hotchk155/six4mix/docs/six4mix packing slip.docx

six4mix 6:1 audio

six4mix is a basic, six input, summing mixer taking 12HP in 1U format. It has a mono signal path and AC coupled inputs. It is ideal for creating sub-mixes within the rack for further filtering (e.g. for percussion kits) but can also be used as a simple master mixer, with the added benefit of a line level output (e.g. for connecting to external amplification or recording equipment)

Each input accepts a modular level audio signal and has a corresponding level potentiometer which allows signal level to be adjusted from muted to 2x voltage gain. Turn the level knob fully to the left to mute a signal.

The white markings on the fascia indicate the signal inputs and level knobs for even numbered channels, with the remaining sockets and knobs for the odd numbered channels.

The modular level summed mix is output from the MIX OUT socket and an attenuated (line level) buffered copy of the same signal is output from the LINE LVL socket. The black knob to the far right is the master output level which offers an additional 1.6x voltage gain. Reduce this level if the output is clipping.

six4mix is fitted with a front panel which fits into ‘Intellijel’ standard height 1U racks. It is also supplied with an alternative front panel to fit ‘Pulp Logic’ standard height 1U racks. Temporarily remove the knobs from the pots and nuts from the sockets to switch the panels.

When attaching the supplied power cable, ensure that the red stripe on the cable matches up with the ‘Red Stripe’ marking beside the power input pins. Take care not to damage the pins or pull the small power adaptor board when plugging or unplugging the power cable from the module.

Please check out six4pix.com/six4mix for more information
