hotchk155/six4mix/fascia/frontsilk.png

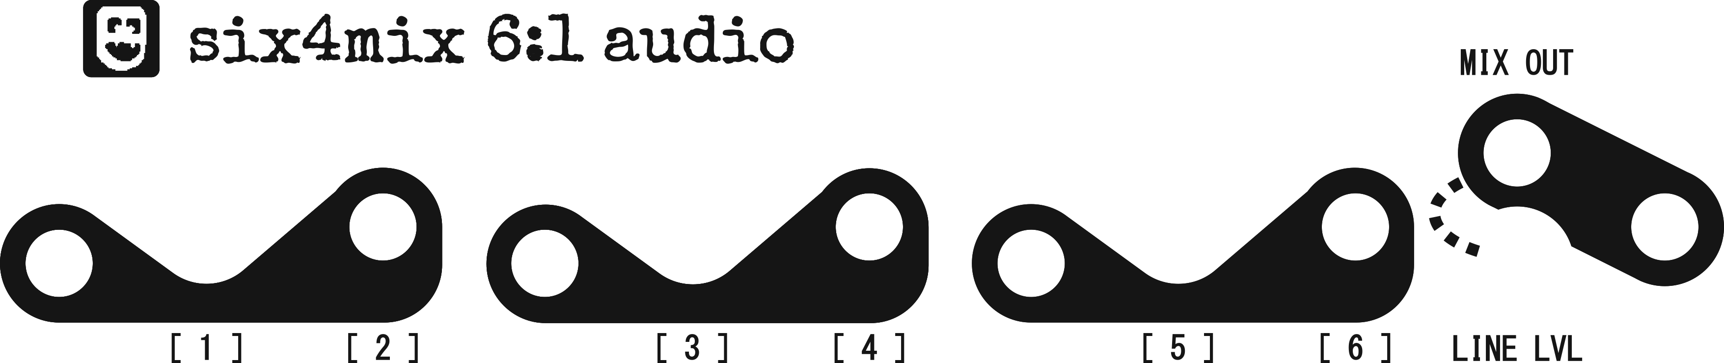
fascia/frontsilk.png
