hotchk155/six4mix/docs/six4mix_BOM.xlsx

 |  |  | 30
C3, C4, C7, C8 ,C11, C12, C15, C16 | 100nF Capacitor 0805 | 8 | 240 | 0.05 | 0.4
D1, D2 | MBR0520LT Schottky Diode | 2 | 60 | 0.15 | 0.3
FB1, FB2 | Ferrite Bead 0603 | 2 | 60 | 0.05 | 0.1
IC1, IC2, IC3, IC4 | NE5532ADR Op-Amp | 4 | 120 | 0.4 | 1.6
R1 | 100k Resistor 0805 | 1 | 30 | 0.02 | 0.02
R2, R4, R5, R7, R8, R9, R11, R13 | 10k Resistor 0805 | 14 | 420 | 0.02 | 0.28
R14, R15, R17, R19, R20, R21 |  |  |  |  | 0
R3 | 47k Resistor 0805 | 1 | 30 | 0.02 | 0.02
R6, R10, R12, R16, R18, R22 | 4k7 Resistor 0805 | 6 | 180 | 0.02 | 0.12
Panel jack x 8 | PJ301M Jack Thonkiconn | 8 | 240 | 0.22 | 1.76
Panel pots x 7 | ALPS 9MM Pot A100K | 7 | 210 | 0.8 | 5.6
C1, C2, C5, C6, C9, C10, C13, C14, C17, C18 | Electrolytic cap 10uF | 10 | 300 | 0.05 | 0.5
Front panel PCB Intellijel |  | 1 | 30 | 0.8 | 0.8
Front panel PCB Pulp |  | 1 | 30 | 0.8 | 0.8
Main PCB |  | 1 | 30 | 0.5 | 0.5
Power connection PCB |  | 1 | 30 | 0.2 | 0.2
Panel jack nuts x 8 |  | 8 | 240 | 0.05 | 0.4
SMT DIL connector 10 pin |  | 1 | 30 | 0.05 | 0.05
3 pin SIL header |  | 1 | 30 | 0.01 | 0.01
Power ribbon cable | Thonk cable | 1 | 30 | 1.59 | 1.59
Black pot topper knob x 1 | Thonk topper | 1 | 30 | 0.25 | 0.25
Gray pot topper knob x 6 | Thonk topper | 6 | 180 | 0.25 | 1.5
Knurlies |  | 4 | 120 | 0.27 | 1.08
Box |  | 1 | 30 | 0.3 | 0.3
Labour |  | 0.5 | 15 | 15 | 7.5
