hotchk155/six4mix/six4mix_power/six4mix_power.brd

## EAGLE design six4mix_power/six4mix_power.brd (2022-11-22)

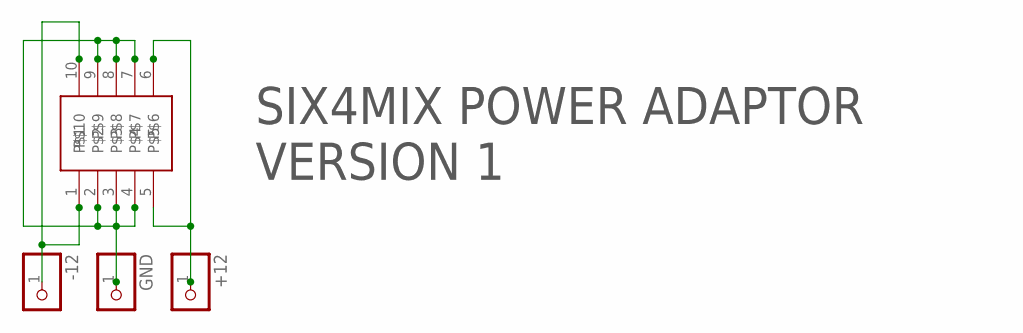
[picture p2: schematic six4mix_power.sch]

Parts:
+12: PINHD-1X1; 1X01
-12: PINHD-1X1; 1X01
GND: PINHD-1X1; 1X01
U$1: 2X5SMT

Connections:
GND: GND.1, U$1.2, U$1.3, U$1.4, U$1.7, U$1.8, U$1.9
unnamed: -12.1, U$1.1, U$1.10
unnamed: +12.1, U$1.5, U$1.6

Notes on the sheet:
SIX4MIX POWER ADAPTOR VERSION 1

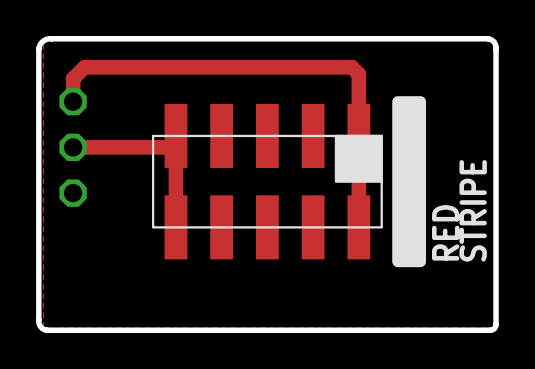
[picture p3: board six4mix_power.brd from above]

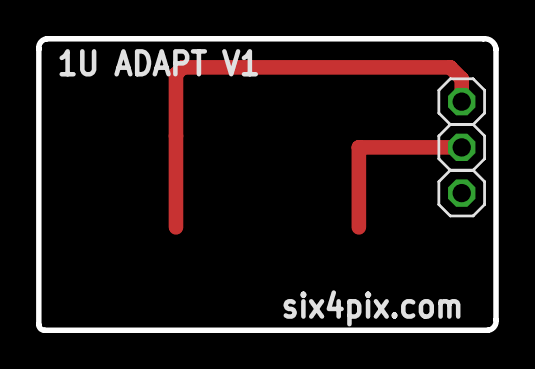
[picture p4: board six4mix_power.brd from below]

Board: 2 copper layers, 25.4 x 16.2 mm, 4 parts (3 on the bottom side), 3 nets.
