hotchk155/six4mix/hardware/six4mix.brd

## EAGLE design hardware/six4mix.brd (2022-08-08)

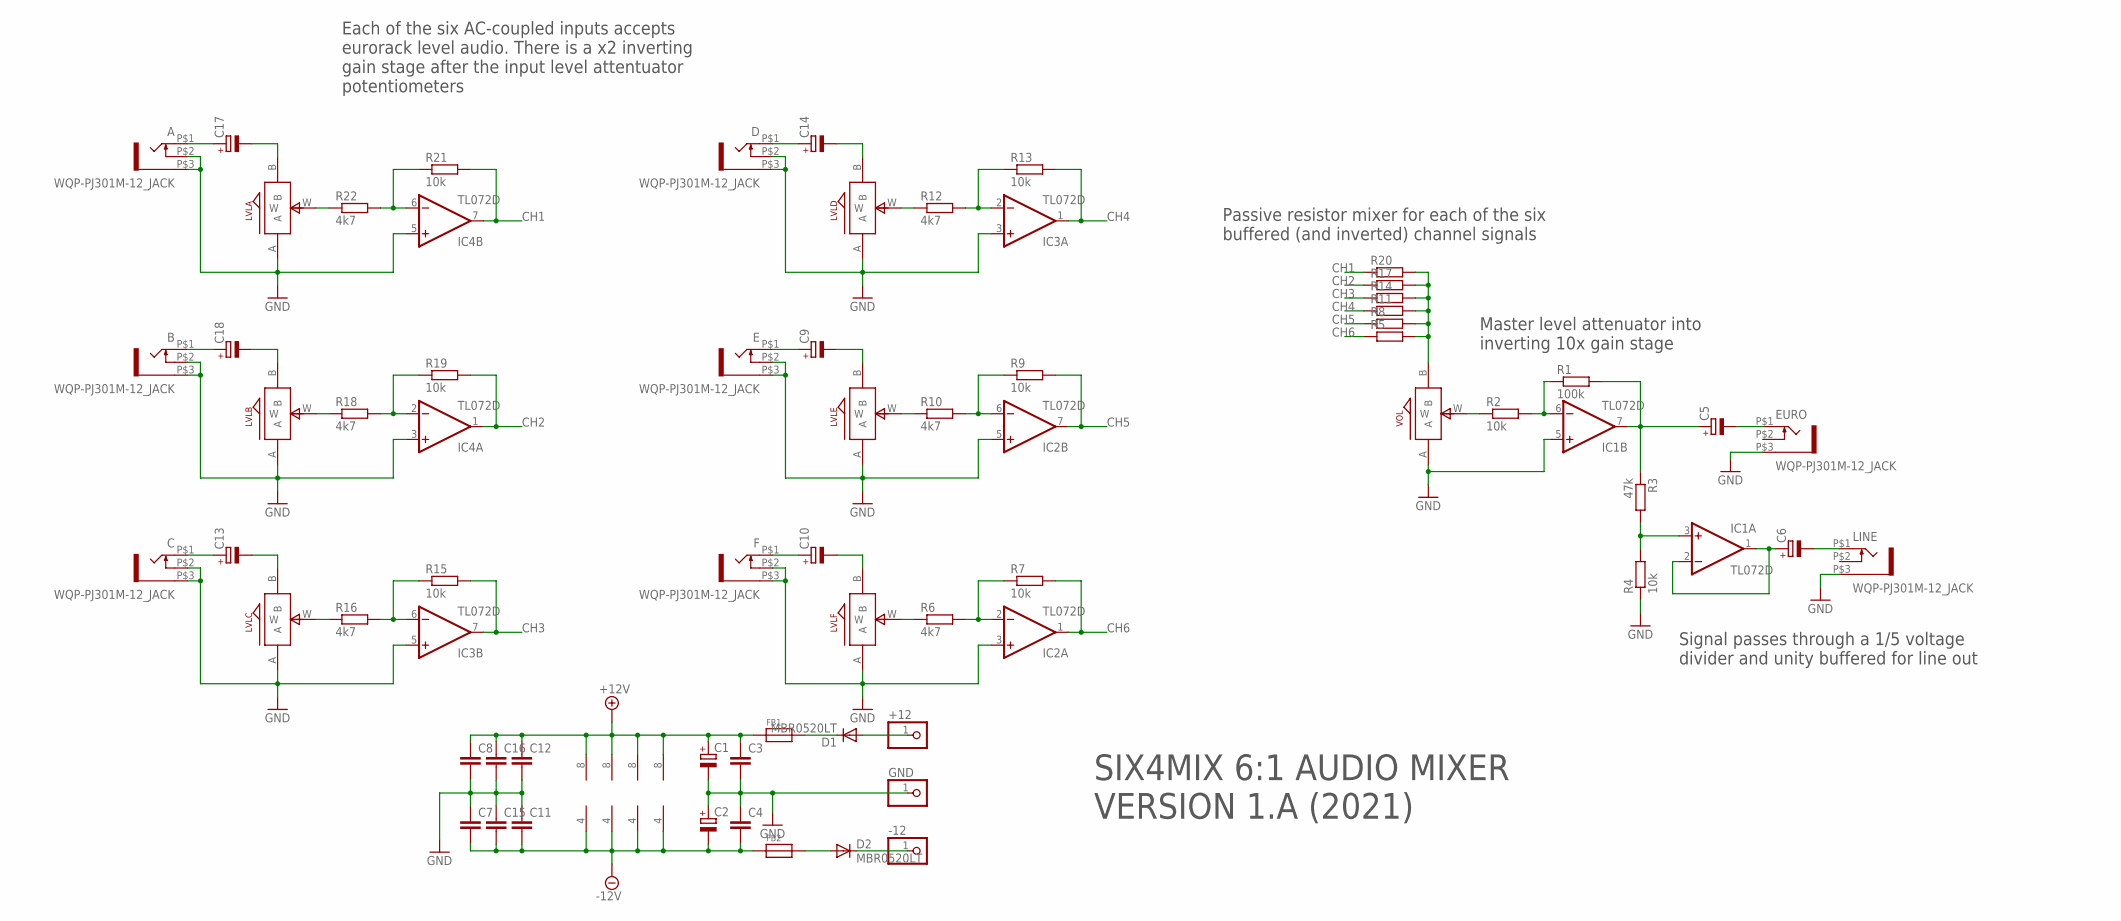
[picture p5: schematic six4mix.sch]

Parts:
+12: PINHD-1X1; 1X01
-12: PINHD-1X1; 1X01
A: WQP-PJ301M-12_JACK
B: WQP-PJ301M-12_JACK
C: WQP-PJ301M-12_JACK
C1, C2, C5, C6, C9, C10, C13, C14, C17, C18: CPOL-EUE2-4; E2-4
C3, C4, C7, C8, C11, C12, C15, C16: C-EUC0805; C0805
D: WQP-PJ301M-12_JACK
D1, D2: MBR0520LT; SOD123
E: WQP-PJ301M-12_JACK
EURO: WQP-PJ301M-12_JACK
F: WQP-PJ301M-12_JACK
FB1, FB2: FERRITE; 0603
GND: PINHD-1X1; 1X01
IC1, IC2, IC3, IC4: TL072D; SO08
LINE: WQP-PJ301M-12_JACK
LVLA: ALPS_POT_SMALL; SMALL_ALPS_POT
LVLB: ALPS_POT_SMALL; SMALL_ALPS_POT
LVLC: ALPS_POT_SMALL; SMALL_ALPS_POT
LVLD: ALPS_POT_SMALL; SMALL_ALPS_POT
LVLE: ALPS_POT_SMALL; SMALL_ALPS_POT
LVLF: ALPS_POT_SMALL; SMALL_ALPS_POT
R1: 100k; R0805
R2, R4, R7, R9, R13, R15, R19, R21: 10k; R0805
R3: 47k; R0805
R5, R8, R11, R14, R17, R20: R-EU_R0805; R0805
R6, R10, R12, R16, R18, R22: 4k7; R0805
VOL: ALPS_POT_SMALL; SMALL_ALPS_POT

Connections:
+12V: C1.+, C3.1, C8.1, C12.1, C16.1, FB1.1, IC1.8 (V+), IC2.8 (V+), IC3.8 (V+), IC4.8 (V+)
-12V: C2.-, C4.2, C7.2, C11.2, C15.2, FB2.1, IC1.4 (V-), IC2.4 (V-), IC3.4 (V-), IC4.4 (V-)
CH1: IC4.7 (OUT), R20.1, R21.2
CH2: IC4.1 (OUT), R17.1, R19.2
CH3: IC3.7 (OUT), R14.1, R15.2
CH4: IC3.1 (OUT), R11.1, R13.2
CH5: IC2.7 (OUT), R8.1, R9.2
CH6: IC2.1 (OUT), R5.1, R7.2
GND: A.P$2 (3), A.P$3 (1), B.P$2 (3), B.P$3 (1), C.P$2 (3), C.P$3 (1), C1.-, C2.+, C3.2, C4.1, C7.1, C8.2, C11.1, C12.2, C15.1, C16.2, D.P$2 (3), D.P$3 (1), E.P$2 (3), E.P$3 (1), EURO.P$3 (1), F.P$2 (3), F.P$3 (1), GND.1, IC1.5 (+IN), IC2.3 (+IN), IC2.5 (+IN), IC3.3 (+IN), IC3.5 (+IN), IC4.3 (+IN), IC4.5 (+IN), LINE.P$3 (1), LVLA.A, LVLB.A, LVLC.A, LVLD.A, LVLE.A, LVLF.A, R4.1, VOL.A
unnamed: C9.+, E.P$1 (2)
unnamed: C9.-, LVLE.B
unnamed: IC2.6 (-IN), R9.1, R10.2
unnamed: LVLE.W, R10.1
unnamed: C10.+, F.P$1 (2)
unnamed: C10.-, LVLF.B
unnamed: IC2.2 (-IN), R6.2, R7.1
unnamed: LVLF.W, R6.1
unnamed: C.P$1 (2), C13.+
unnamed: C13.-, LVLC.B
unnamed: IC3.6 (-IN), R15.1, R16.2
unnamed: LVLC.W, R16.1
unnamed: C14.+, D.P$1 (2)
unnamed: C14.-, LVLD.B
unnamed: IC3.2 (-IN), R12.2, R13.1
unnamed: LVLD.W, R12.1
unnamed: A.P$1 (2), C17.+
unnamed: C17.-, LVLA.B
unnamed: IC4.6 (-IN), R21.1, R22.2
unnamed: LVLA.W, R22.1
unnamed: B.P$1 (2), C18.+
unnamed: C18.-, LVLB.B
unnamed: IC4.2 (-IN), R18.2, R19.1
unnamed: LVLB.W, R18.1
unnamed: R5.2, R8.2, R11.2, R14.2, R17.2, R20.2, VOL.B
unnamed: C5.-, EURO.P$1 (2)
unnamed: C6.-, LINE.P$1 (2)
unnamed: R2.1, VOL.W
unnamed: IC1.6 (-IN), R1.1, R2.2
unnamed: C5.+, IC1.7 (OUT), R1.2, R3.1
unnamed: D1.C, FB1.2
unnamed: C6.+, IC1.1 (OUT), IC1.2 (-IN)
unnamed: IC1.3 (+IN), R3.2, R4.2
unnamed: +12.1, D1.A
unnamed: D2.A, FB2.2
unnamed: -12.1, D2.C

Notes on the sheet:
Each of the six AC-coupled inputs accepts eurorack level audio. There is a x2 inverting gain stage after the input level attentuator potentiometers
Passive resistor mixer for each of the six buffered (and inverted) channel signals
Master level attenuator into inverting 10x gain stage
Signal passes through a 1/5 voltage divider and unity buffered for line out
SIX4MIX 6:1 AUDIO MIXER VERSION 1.A (2021)

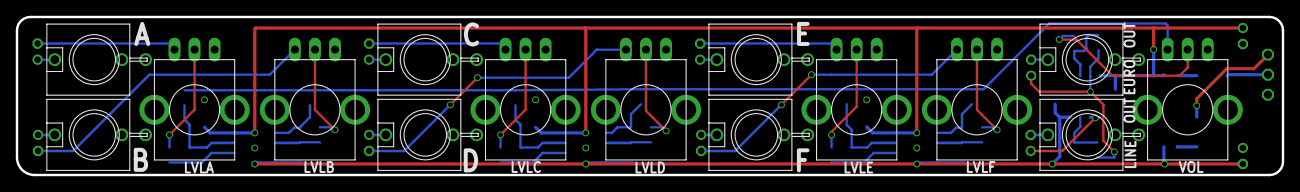
[picture p6: board six4mix.brd from above]

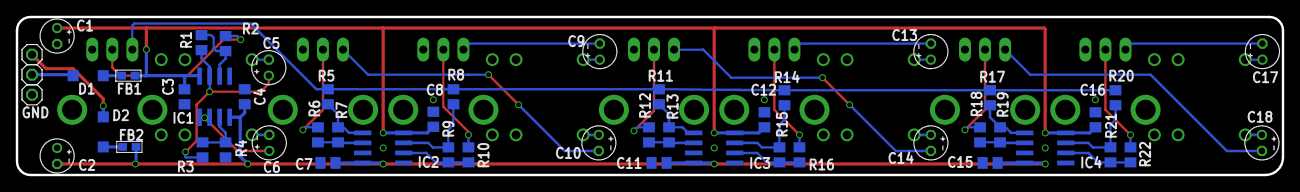
[picture p7: board six4mix.brd from below]

Board: 2 copper layers, 160.3 x 20.0 mm, 66 parts (51 on the bottom side), 45 nets.
