hotchk155/six4mix/power_panel_stencil/six4mix_power_panel_stencil.brd

## EAGLE design power_panel_stencil/six4mix_power_panel_stencil.brd (2022-11-22)

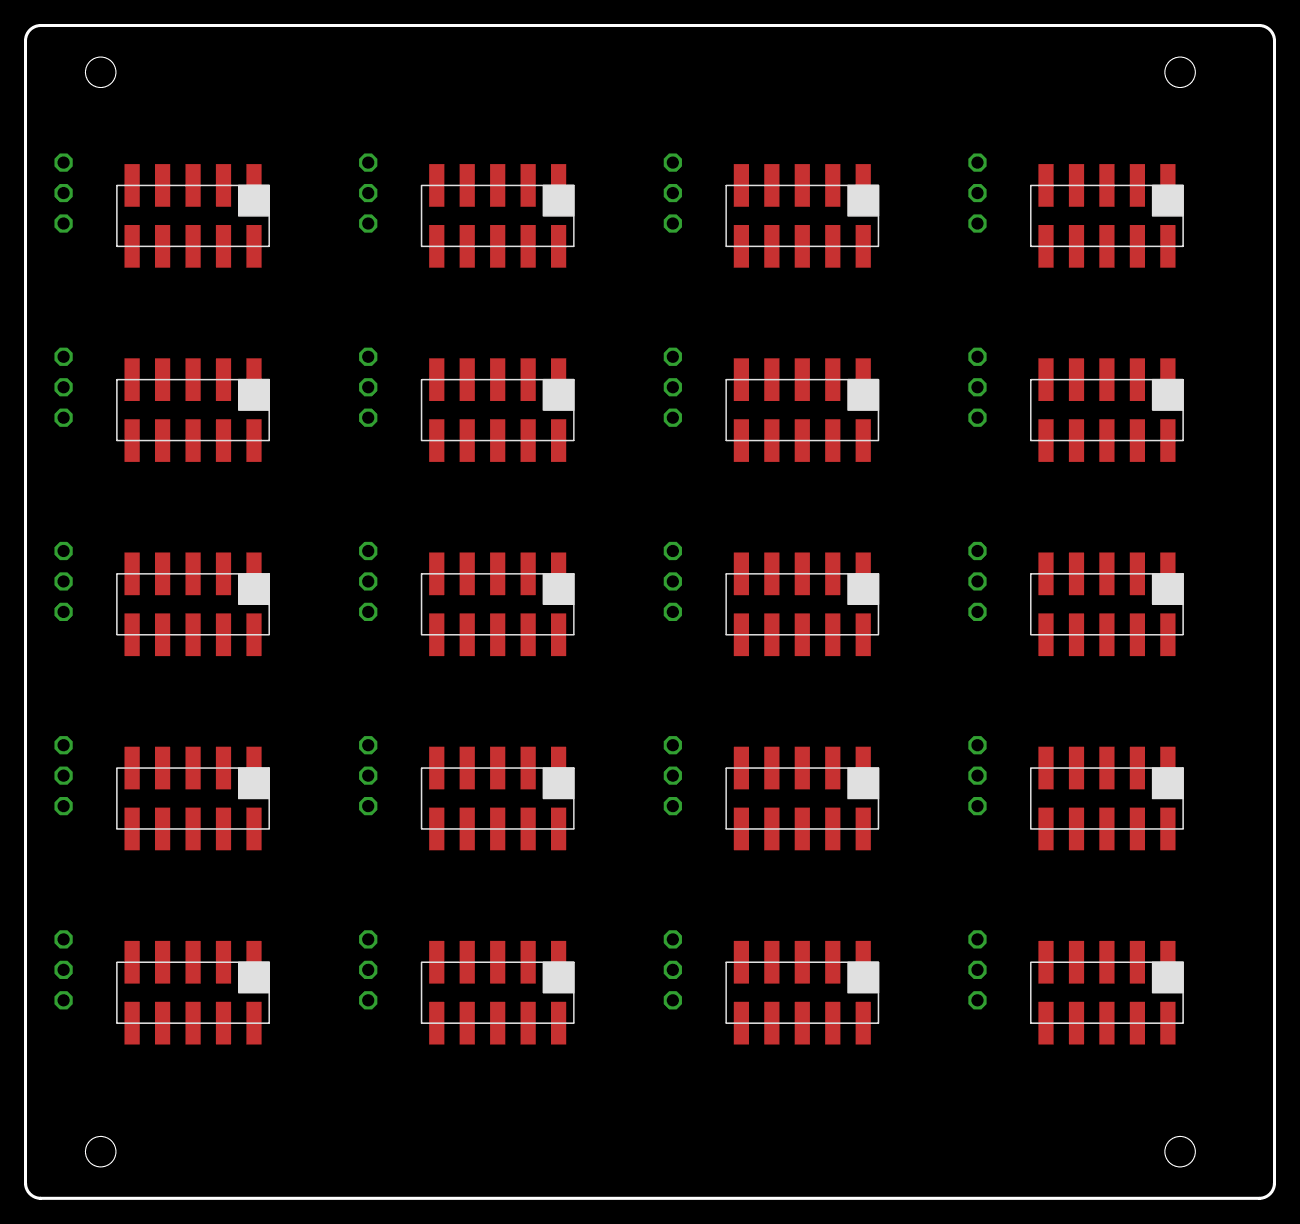
[picture p8: board six4mix_power_panel_stencil.brd from above]

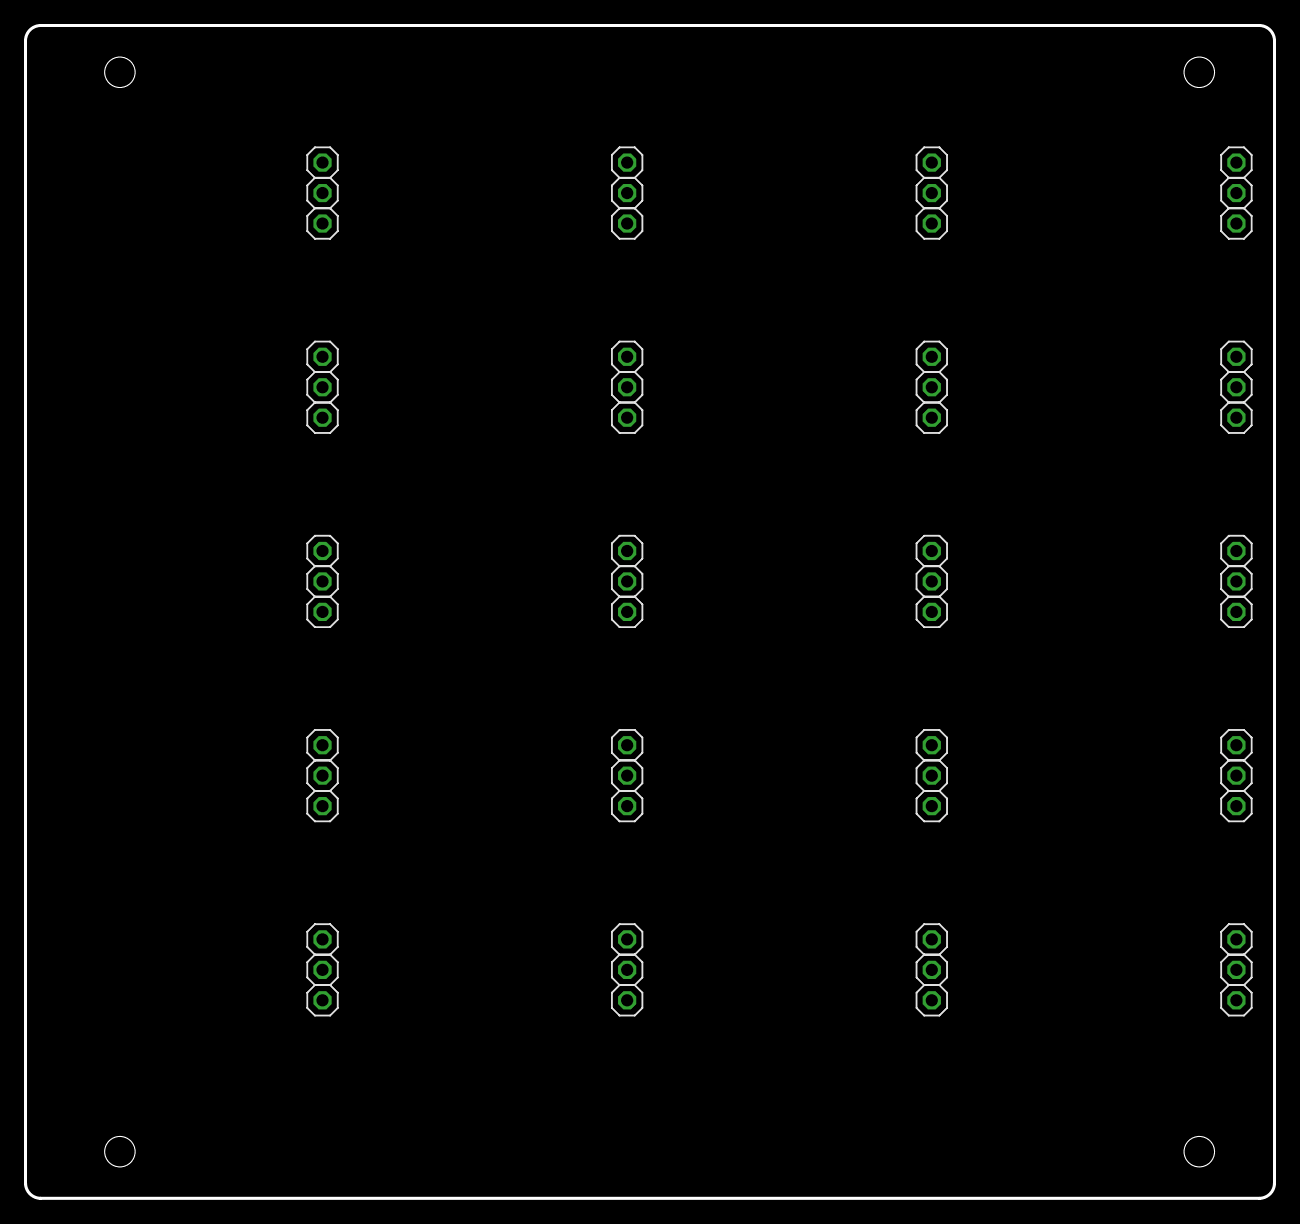
[picture p9: board six4mix_power_panel_stencil.brd from below]

Board: 2 copper layers, 104.1 x 97.8 mm, 80 parts (60 on the bottom side), 60 nets, no tracks yet.

Parts:
+1, +2, +3, +4, +5, +6, +7, +8, +9, +10, +11, +12, +13, +14, +15, +16, +17, +18, +19, +20: 1X01
-1, -2, -3, -4, -5, -6, -7, -8, -9, -10, -11, -12, -13, -14, -15, -16, -17, -18, -19, -20: 1X01
GND, GND1, GND2, GND3, GND4, GND5, GND6, GND7, GND8, GND9, GND10, GND11, GND12, GND13, GND14, GND15, GND16, GND17, GND18, GND19: 1X01
U$1, U$2, U$3, U$4, U$5, U$6, U$7, U$8, U$9, U$10, U$11, U$12, U$13, U$14, U$15, U$16, U$17, U$18, U$19, U$20: 2X5SMT

Connections:
GND: GND.1, U$1.2, U$1.3, U$1.4, U$1.7, U$1.8, U$1.9
GND1: GND1.1, U$2.2, U$2.3, U$2.4, U$2.7, U$2.8, U$2.9
GND2: GND2.1, U$3.2, U$3.3, U$3.4, U$3.7, U$3.8, U$3.9
GND3: GND3.1, U$4.2, U$4.3, U$4.4, U$4.7, U$4.8, U$4.9
GND4: GND4.1, U$5.2, U$5.3, U$5.4, U$5.7, U$5.8, U$5.9
GND5: GND5.1, U$6.2, U$6.3, U$6.4, U$6.7, U$6.8, U$6.9
GND6: GND6.1, U$7.2, U$7.3, U$7.4, U$7.7, U$7.8, U$7.9
GND7: GND7.1, U$8.2, U$8.3, U$8.4, U$8.7, U$8.8, U$8.9
GND8: GND8.1, U$9.2, U$9.3, U$9.4, U$9.7, U$9.8, U$9.9
GND9: GND9.1, U$10.2, U$10.3, U$10.4, U$10.7, U$10.8, U$10.9
GND10: GND10.1, U$11.2, U$11.3, U$11.4, U$11.7, U$11.8, U$11.9
GND11: GND11.1, U$12.2, U$12.3, U$12.4, U$12.7, U$12.8, U$12.9
GND12: GND12.1, U$13.2, U$13.3, U$13.4, U$13.7, U$13.8, U$13.9
GND13: GND13.1, U$14.2, U$14.3, U$14.4, U$14.7, U$14.8, U$14.9
GND14: GND14.1, U$15.2, U$15.3, U$15.4, U$15.7, U$15.8, U$15.9
GND15: GND15.1, U$16.2, U$16.3, U$16.4, U$16.7, U$16.8, U$16.9
GND16: GND16.1, U$17.2, U$17.3, U$17.4, U$17.7, U$17.8, U$17.9
GND17: GND17.1, U$18.2, U$18.3, U$18.4, U$18.7, U$18.8, U$18.9
GND18: GND18.1, U$19.2, U$19.3, U$19.4, U$19.7, U$19.8, U$19.9
GND19: GND19.1, U$20.2, U$20.3, U$20.4, U$20.7, U$20.8, U$20.9
unnamed: -12.1, U$1.1, U$1.10
unnamed: +12.1, U$1.5, U$1.6
unnamed: -1.1, U$2.1, U$2.10
unnamed: +1.1, U$2.5, U$2.6
unnamed: -2.1, U$3.1, U$3.10
unnamed: +2.1, U$3.5, U$3.6
unnamed: -3.1, U$4.1, U$4.10
unnamed: +3.1, U$4.5, U$4.6
unnamed: -4.1, U$5.1, U$5.10
unnamed: +4.1, U$5.5, U$5.6
unnamed: -5.1, U$6.1, U$6.10
unnamed: +5.1, U$6.5, U$6.6
unnamed: -6.1, U$7.1, U$7.10
unnamed: +6.1, U$7.5, U$7.6
unnamed: -7.1, U$8.1, U$8.10
unnamed: +7.1, U$8.5, U$8.6
unnamed: -8.1, U$9.1, U$9.10
unnamed: +8.1, U$9.5, U$9.6
unnamed: -9.1, U$10.1, U$10.10
unnamed: +9.1, U$10.5, U$10.6
unnamed: -10.1, U$11.1, U$11.10
unnamed: +10.1, U$11.5, U$11.6
unnamed: -11.1, U$12.1, U$12.10
unnamed: +11.1, U$12.5, U$12.6
unnamed: -13.1, U$13.1, U$13.10
unnamed: +13.1, U$13.5, U$13.6
unnamed: -14.1, U$14.1, U$14.10
unnamed: +14.1, U$14.5, U$14.6
unnamed: -15.1, U$15.1, U$15.10
unnamed: +15.1, U$15.5, U$15.6
unnamed: -16.1, U$16.1, U$16.10
unnamed: +16.1, U$16.5, U$16.6
unnamed: -17.1, U$17.1, U$17.10
unnamed: +17.1, U$17.5, U$17.6
unnamed: -18.1, U$18.1, U$18.10
unnamed: +18.1, U$18.5, U$18.6
unnamed: -19.1, U$19.1, U$19.10
unnamed: +19.1, U$19.5, U$19.6
unnamed: -20.1, U$20.1, U$20.10
unnamed: +20.1, U$20.5, U$20.6
