hotchk155/six4mix/stencil/six4mix_stencil.brd

## EAGLE design stencil/six4mix_stencil.brd (2022-08-08)

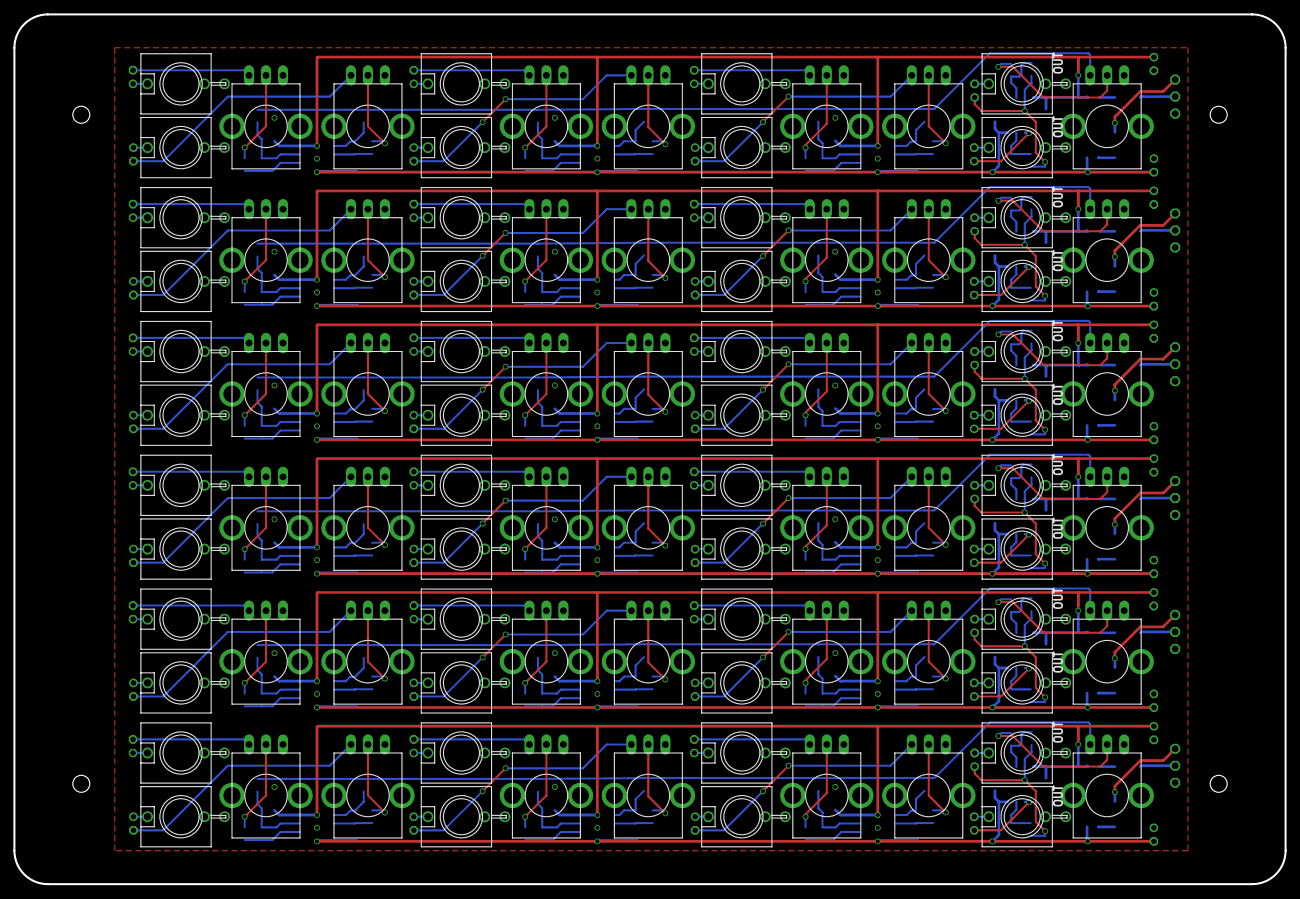
[picture p10: board six4mix_stencil.brd from above]

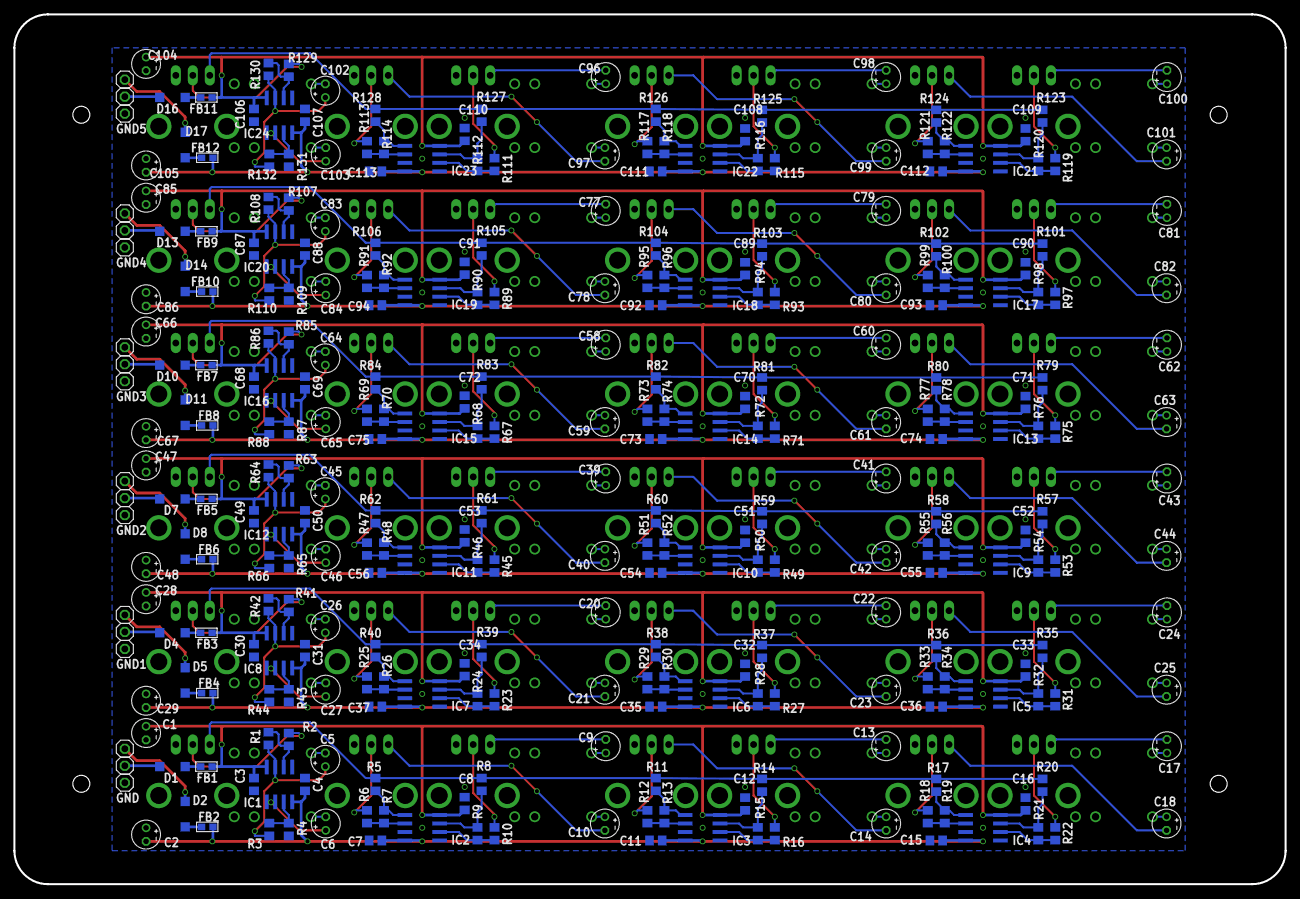
[picture p11: board six4mix_stencil.brd from below]

Board: 2 copper layers, 190.0 x 130.0 mm, 396 parts (306 on the bottom side), 265 nets.

Parts:
+1, +2, +3, +4, +5, +12: 1X01
-1, -2, -3, -4, -5, -12: 1X01
A, A1, A2, A3, A4, A5: WQP-PJ301M-12_JACK
B, B1, B2, B3, B4, B5: WQP-PJ301M-12_JACK
C, C19, C38, C57, C76, C95: WQP-PJ301M-12_JACK
C1, C2, C5, C6, C9, C10, C13, C14, C17, C18, C20, C21, C22, C23, C24, C25, C26, C27, C28, C29, C39, C40, C41, C42, C43, C44, C45, C46, C47, C48, C58, C59, C60, C61, C62, C63, C64, C65, C66, C67, C77, C78, C79, C80, C81, C82, C83, C84, C85, C86, C96, C97, C98, C99, C100, C101, C102, C103, C104, C105: E2-4
C3, C4, C7, C8, C11, C12, C15, C16, C30, C31, C32, C33, C34, C35, C36, C37, C49, C50, C51, C52, C53, C54, C55, C56, C68, C69, C70, C71, C72, C73, C74, C75, C87, C88, C89, C90, C91, C92, C93, C94, C106, C107, C108, C109, C110, C111, C112, C113: C0805
D, D3, D6, D9, D12, D15: WQP-PJ301M-12_JACK
D1, D2, D4, D5, D7, D8, D10, D11, D13, D14, D16, D17: MBR0520LT; SOD123
E, E1, E2, E3, E4, E5: WQP-PJ301M-12_JACK
EURO, EURO1, EURO2, EURO3, EURO4, EURO5: WQP-PJ301M-12_JACK
F, F1, F2, F3, F4, F5: WQP-PJ301M-12_JACK
FB1, FB2, FB3, FB4, FB5, FB6, FB7, FB8, FB9, FB10, FB11, FB12: 0603
GND, GND1, GND2, GND3, GND4, GND5: 1X01
IC1, IC2, IC3, IC4, IC5, IC6, IC7, IC8, IC9, IC10, IC11, IC12, IC13, IC14, IC15, IC16, IC17, IC18, IC19, IC20, IC21, IC22, IC23, IC24: TL072D; SO08
LINE, LINE1, LINE2, LINE3, LINE4, LINE5: WQP-PJ301M-12_JACK
LVLA, LVLA1, LVLA2, LVLA3, LVLA4, LVLA5: ALPS_POT_SMALL; SMALL_ALPS_POT
LVLB, LVLB1, LVLB2, LVLB3, LVLB4, LVLB5: ALPS_POT_SMALL; SMALL_ALPS_POT
LVLC, LVLC1, LVLC2, LVLC3, LVLC4, LVLC5: ALPS_POT_SMALL; SMALL_ALPS_POT
LVLD, LVLD1, LVLD2, LVLD3, LVLD4, LVLD5: ALPS_POT_SMALL; SMALL_ALPS_POT
LVLE, LVLE1, LVLE2, LVLE3, LVLE4, LVLE5: ALPS_POT_SMALL; SMALL_ALPS_POT
LVLF, LVLF1, LVLF2, LVLF3, LVLF4, LVLF5: ALPS_POT_SMALL; SMALL_ALPS_POT
R1, R42, R64, R86, R108, R130: 100k; R0805
R2, R4, R7, R9, R13, R15, R19, R21, R24, R26, R28, R30, R32, R34, R41, R43, R46, R48, R50, R52, R54, R56, R63, R65, R68, R70, R72, R74, R76, R78, R85, R87, R90, R92, R94, R96, R98, R100, R107, R109, R112, R114, R116, R118, R120, R122, R129, R131: 10k; R0805
R3, R44, R66, R88, R110, R132: 47k; R0805
R5, R8, R11, R14, R17, R20, R35, R36, R37, R38, R39, R40, R57, R58, R59, R60, R61, R62, R79, R80, R81, R82, R83, R84, R101, R102, R103, R104, R105, R106, R123, R124, R125, R126, R127, R128: R0805
R6, R10, R12, R16, R18, R22, R23, R25, R27, R29, R31, R33, R45, R47, R49, R51, R53, R55, R67, R69, R71, R73, R75, R77, R89, R91, R93, R95, R97, R99, R111, R113, R115, R117, R119, R121: 4k7; R0805
VOL, VOL1, VOL2, VOL3, VOL4, VOL5: ALPS_POT_SMALL; SMALL_ALPS_POT

Connections:
+12V: C1.+, C3.1, C8.1, C12.1, C16.1, FB1.1, IC1.8, IC2.8, IC3.8, IC4.8
+12V1: C28.+, C30.1, C32.1, C33.1, C34.1, FB3.1, IC5.8, IC6.8, IC7.8, IC8.8
+12V2: C47.+, C49.1, C51.1, C52.1, C53.1, FB5.1, IC9.8, IC10.8, IC11.8, IC12.8
+12V3: C66.+, C68.1, C70.1, C71.1, C72.1, FB7.1, IC13.8, IC14.8, IC15.8, IC16.8
+12V4: C85.+, C87.1, C89.1, C90.1, C91.1, FB9.1, IC17.8, IC18.8, IC19.8, IC20.8
+12V5: C104.+, C106.1, C108.1, C109.1, C110.1, FB11.1, IC21.8, IC22.8, IC23.8, IC24.8
-12V: C2.-, C4.2, C7.2, C11.2, C15.2, FB2.1, IC1.4, IC2.4, IC3.4, IC4.4
-12V1: C29.-, C31.2, C35.2, C36.2, C37.2, FB4.1, IC5.4, IC6.4, IC7.4, IC8.4
-12V2: C48.-, C50.2, C54.2, C55.2, C56.2, FB6.1, IC9.4, IC10.4, IC11.4, IC12.4
-12V3: C67.-, C69.2, C73.2, C74.2, C75.2, FB8.1, IC13.4, IC14.4, IC15.4, IC16.4
-12V4: C86.-, C88.2, C92.2, C93.2, C94.2, FB10.1, IC17.4, IC18.4, IC19.4, IC20.4
-12V5: C105.-, C107.2, C111.2, C112.2, C113.2, FB12.1, IC21.4, IC22.4, IC23.4, IC24.4
CH1: IC4.7, R20.1, R21.2
CH2: IC4.1, R17.1, R19.2
CH3: IC3.7, R14.1, R15.2
CH4: IC3.1, R11.1, R13.2
CH5: IC2.7, R8.1, R9.2
CH6: IC2.1, R5.1, R7.2
CH7: IC5.7, R32.2, R35.1
CH8: IC5.1, R34.2, R36.1
CH9: IC6.7, R28.2, R37.1
CH10: IC6.1, R30.2, R38.1
CH11: IC7.7, R24.2, R39.1
CH12: IC7.1, R26.2, R40.1
CH13: IC9.7, R54.2, R57.1
CH14: IC9.1, R56.2, R58.1
CH15: IC10.7, R50.2, R59.1
CH16: IC10.1, R52.2, R60.1
CH17: IC11.7, R46.2, R61.1
CH18: IC11.1, R48.2, R62.1
CH19: IC13.7, R76.2, R79.1
CH20: IC13.1, R78.2, R80.1
CH21: IC14.7, R72.2, R81.1
CH22: IC14.1, R74.2, R82.1
CH23: IC15.7, R68.2, R83.1
CH24: IC15.1, R70.2, R84.1
CH25: IC17.7, R98.2, R101.1
CH26: IC17.1, R100.2, R102.1
CH27: IC18.7, R94.2, R103.1
CH28: IC18.1, R96.2, R104.1
CH29: IC19.7, R90.2, R105.1
CH30: IC19.1, R92.2, R106.1
CH31: IC21.7, R120.2, R123.1
CH32: IC21.1, R122.2, R124.1
CH33: IC22.7, R116.2, R125.1
CH34: IC22.1, R118.2, R126.1
CH35: IC23.7, R112.2, R127.1
CH36: IC23.1, R114.2, R128.1
GND: A.P$2, A.P$3, A1.P$2, A1.P$3, A2.P$2, A2.P$3, A3.P$2, A3.P$3, A4.P$2, A4.P$3, A5.P$2, A5.P$3, B.P$2, B.P$3, B1.P$2, B1.P$3, B2.P$2, B2.P$3, B3.P$2, B3.P$3, B4.P$2, B4.P$3, B5.P$2, B5.P$3, C.P$2, C.P$3, C1.-, C2.+, C3.2, C4.1, C7.1, C8.2, C11.1, C12.2, C15.1, C16.2, C19.P$2, C19.P$3, C28.-, C29.+, C30.2, C31.1, C32.2, C33.2, C34.2, C35.1, C36.1, C37.1, C38.P$2, C38.P$3, C47.-, C48.+, C49.2, C50.1, C51.2, C52.2, C53.2, C54.1, C55.1, C56.1, C57.P$2, C57.P$3, C66.-, C67.+, C68.2, C69.1, C70.2, C71.2, C72.2, C73.1, C74.1, C75.1, C76.P$2, C76.P$3, C85.-, C86.+, C87.2, C88.1, C89.2, C90.2, C91.2, C92.1, C93.1, C94.1, C95.P$2, C95.P$3, C104.-, C105.+, C106.2, C107.1, C108.2, C109.2, C110.2, C111.1, C112.1, C113.1, D.P$2, D.P$3, D3.P$2, D3.P$3, D6.P$2, D6.P$3, D9.P$2, D9.P$3, D12.P$2, D12.P$3, D15.P$2, D15.P$3, E.P$2, E.P$3, E1.P$2, E1.P$3, E2.P$2, E2.P$3, E3.P$2, E3.P$3, E4.P$2, E4.P$3, E5.P$2, E5.P$3, EURO.P$3, EURO1.P$3, EURO2.P$3, EURO3.P$3, EURO4.P$3, EURO5.P$3, F.P$2, F.P$3, F1.P$2, F1.P$3, F2.P$2, F2.P$3, F3.P$2, F3.P$3, F4.P$2, F4.P$3, F5.P$2, F5.P$3, GND.1, GND1.1, GND2.1, GND3.1, GND4.1, GND5.1, IC1.5, IC2.3, IC2.5, IC3.3, IC3.5, IC4.3, IC4.5, IC5.3, IC5.5, IC6.3, IC6.5, IC7.3, IC7.5, IC8.5, IC9.3, IC9.5, IC10.3, IC10.5, IC11.3, IC11.5, IC12.5, IC13.3, IC13.5, IC14.3, IC14.5, IC15.3, IC15.5, IC16.5, IC17.3, IC17.5, IC18.3, IC18.5, IC19.3, IC19.5, IC20.5, IC21.3, IC21.5, IC22.3, IC22.5, IC23.3, IC23.5, IC24.5, LINE.P$3, LINE1.P$3, LINE2.P$3, LINE3.P$3, LINE4.P$3, LINE5.P$3, LVLA.A, LVLA1.A, LVLA2.A, LVLA3.A, LVLA4.A, LVLA5.A, LVLB.A, LVLB1.A, LVLB2.A, LVLB3.A, LVLB4.A, LVLB5.A, LVLC.A, LVLC1.A, LVLC2.A, LVLC3.A, LVLC4.A, LVLC5.A, LVLD.A, LVLD1.A, LVLD2.A, LVLD3.A, LVLD4.A, LVLD5.A, LVLE.A, LVLE1.A, LVLE2.A, LVLE3.A, LVLE4.A, LVLE5.A, LVLF.A, LVLF1.A, LVLF2.A, LVLF3.A, LVLF4.A, LVLF5.A, R4.1, R43.1, R65.1, R87.1, R109.1, R131.1, VOL.A, VOL1.A, VOL2.A, VOL3.A, VOL4.A, VOL5.A
unnamed: C9.+, E.P$1
unnamed: C9.-, LVLE.B
unnamed: IC2.6, R9.1, R10.2
unnamed: LVLE.W, R10.1
unnamed: C10.+, F.P$1
unnamed: C10.-, LVLF.B
unnamed: IC2.2, R6.2, R7.1
unnamed: LVLF.W, R6.1
unnamed: C.P$1, C13.+
unnamed: C13.-, LVLC.B
unnamed: IC3.6, R15.1, R16.2
unnamed: LVLC.W, R16.1
unnamed: C14.+, D.P$1
unnamed: C14.-, LVLD.B
unnamed: IC3.2, R12.2, R13.1
unnamed: LVLD.W, R12.1
unnamed: A.P$1, C17.+
unnamed: C17.-, LVLA.B
unnamed: IC4.6, R21.1, R22.2
unnamed: LVLA.W, R22.1
unnamed: B.P$1, C18.+
unnamed: C18.-, LVLB.B
unnamed: IC4.2, R18.2, R19.1
unnamed: LVLB.W, R18.1
unnamed: R5.2, R8.2, R11.2, R14.2, R17.2, R20.2, VOL.B
unnamed: C5.-, EURO.P$1
unnamed: C6.-, LINE.P$1
unnamed: R2.1, VOL.W
unnamed: IC1.6, R1.1, R2.2
unnamed: C5.+, IC1.7, R1.2, R3.1
unnamed: D1.C, FB1.2
unnamed: C6.+, IC1.1, IC1.2
unnamed: IC1.3, R3.2, R4.2
unnamed: +12.1, D1.A
unnamed: D2.A, FB2.2
unnamed: -12.1, D2.C
unnamed: C20.-, LVLE1.B
unnamed: IC7.6, R23.2, R24.1
unnamed: C21.+, F1.P$1
unnamed: C21.-, LVLF1.B
unnamed: IC7.2, R25.2, R26.1
unnamed: LVLF1.W, R25.1
unnamed: C19.P$1, C22.+
unnamed: C22.-, LVLC1.B
unnamed: IC6.6, R27.2, R28.1
unnamed: LVLC1.W, R27.1
unnamed: C23.+, D3.P$1
unnamed: C23.-, LVLD1.B
unnamed: IC6.2, R29.2, R30.1
unnamed: LVLD1.W, R29.1
unnamed: A1.P$1, C24.+
unnamed: C24.-, LVLA1.B
unnamed: IC5.6, R31.2, R32.1
unnamed: LVLA1.W, R31.1
unnamed: B1.P$1, C25.+
unnamed: C25.-, LVLB1.B
unnamed: IC5.2, R33.2, R34.1
unnamed: LVLB1.W, R33.1
unnamed: LVLE1.W, R23.1
unnamed: C20.+, E1.P$1
unnamed: R35.2, R36.2, R37.2, R38.2, R39.2, R40.2, VOL1.B
unnamed: R41.1, VOL1.W
unnamed: IC8.6, R41.2, R42.1
unnamed: C26.+, IC8.7, R42.2, R44.1
unnamed: C26.-, EURO1.P$1
unnamed: C27.-, LINE1.P$1
unnamed: C27.+, IC8.1, IC8.2
unnamed: IC8.3, R43.2, R44.2
unnamed: D4.C, FB3.2
unnamed: +1.1, D4.A
unnamed: D5.A, FB4.2
unnamed: -1.1, D5.C
unnamed: C39.-, LVLE2.B
unnamed: IC11.6, R45.2, R46.1
unnamed: C40.+, F2.P$1
unnamed: C40.-, LVLF2.B
unnamed: IC11.2, R47.2, R48.1
unnamed: LVLF2.W, R47.1
unnamed: C38.P$1, C41.+
unnamed: C41.-, LVLC2.B
unnamed: IC10.6, R49.2, R50.1
unnamed: LVLC2.W, R49.1
unnamed: C42.+, D6.P$1
unnamed: C42.-, LVLD2.B
unnamed: IC10.2, R51.2, R52.1
unnamed: LVLD2.W, R51.1
unnamed: A2.P$1, C43.+
unnamed: C43.-, LVLA2.B
unnamed: IC9.6, R53.2, R54.1
unnamed: LVLA2.W, R53.1
unnamed: B2.P$1, C44.+
unnamed: C44.-, LVLB2.B
unnamed: IC9.2, R55.2, R56.1
unnamed: LVLB2.W, R55.1
unnamed: LVLE2.W, R45.1
unnamed: C39.+, E2.P$1
unnamed: R57.2, R58.2, R59.2, R60.2, R61.2, R62.2, VOL2.B
unnamed: R63.1, VOL2.W
unnamed: IC12.6, R63.2, R64.1
unnamed: C45.+, IC12.7, R64.2, R66.1
unnamed: C45.-, EURO2.P$1
unnamed: C46.-, LINE2.P$1
unnamed: C46.+, IC12.1, IC12.2
unnamed: IC12.3, R65.2, R66.2
unnamed: D7.C, FB5.2
unnamed: +2.1, D7.A
unnamed: D8.A, FB6.2
unnamed: -2.1, D8.C
unnamed: C58.-, LVLE3.B
unnamed: IC15.6, R67.2, R68.1
unnamed: C59.+, F3.P$1
unnamed: C59.-, LVLF3.B
unnamed: IC15.2, R69.2, R70.1
unnamed: LVLF3.W, R69.1
unnamed: C57.P$1, C60.+
unnamed: C60.-, LVLC3.B
unnamed: IC14.6, R71.2, R72.1
unnamed: LVLC3.W, R71.1
unnamed: C61.+, D9.P$1
unnamed: C61.-, LVLD3.B
unnamed: IC14.2, R73.2, R74.1
unnamed: LVLD3.W, R73.1
unnamed: A3.P$1, C62.+
unnamed: C62.-, LVLA3.B
unnamed: IC13.6, R75.2, R76.1
unnamed: LVLA3.W, R75.1
unnamed: B3.P$1, C63.+
unnamed: C63.-, LVLB3.B
unnamed: IC13.2, R77.2, R78.1
unnamed: LVLB3.W, R77.1
unnamed: LVLE3.W, R67.1
unnamed: C58.+, E3.P$1
unnamed: R79.2, R80.2, R81.2, R82.2, R83.2, R84.2, VOL3.B
unnamed: R85.1, VOL3.W
unnamed: IC16.6, R85.2, R86.1
unnamed: C64.+, IC16.7, R86.2, R88.1
unnamed: C64.-, EURO3.P$1
unnamed: C65.-, LINE3.P$1
unnamed: C65.+, IC16.1, IC16.2
unnamed: IC16.3, R87.2, R88.2
unnamed: D10.C, FB7.2
unnamed: +3.1, D10.A
unnamed: D11.A, FB8.2
unnamed: -3.1, D11.C
unnamed: C77.-, LVLE4.B
unnamed: IC19.6, R89.2, R90.1
unnamed: C78.+, F4.P$1
unnamed: C78.-, LVLF4.B
unnamed: IC19.2, R91.2, R92.1
unnamed: LVLF4.W, R91.1
unnamed: C76.P$1, C79.+
unnamed: C79.-, LVLC4.B
unnamed: IC18.6, R93.2, R94.1
unnamed: LVLC4.W, R93.1
unnamed: C80.+, D12.P$1
unnamed: C80.-, LVLD4.B
unnamed: IC18.2, R95.2, R96.1
unnamed: LVLD4.W, R95.1
unnamed: A4.P$1, C81.+
unnamed: C81.-, LVLA4.B
unnamed: IC17.6, R97.2, R98.1
unnamed: LVLA4.W, R97.1
unnamed: B4.P$1, C82.+
unnamed: C82.-, LVLB4.B
unnamed: IC17.2, R99.2, R100.1
unnamed: LVLB4.W, R99.1
unnamed: LVLE4.W, R89.1
unnamed: C77.+, E4.P$1
unnamed: R101.2, R102.2, R103.2, R104.2, R105.2, R106.2, VOL4.B
unnamed: R107.1, VOL4.W
unnamed: IC20.6, R107.2, R108.1
unnamed: C83.+, IC20.7, R108.2, R110.1
unnamed: C83.-, EURO4.P$1
unnamed: C84.-, LINE4.P$1
unnamed: C84.+, IC20.1, IC20.2
unnamed: IC20.3, R109.2, R110.2
unnamed: D13.C, FB9.2
unnamed: +4.1, D13.A
unnamed: D14.A, FB10.2
unnamed: -4.1, D14.C
unnamed: C96.-, LVLE5.B
unnamed: IC23.6, R111.2, R112.1
unnamed: C97.+, F5.P$1
unnamed: C97.-, LVLF5.B
unnamed: IC23.2, R113.2, R114.1
unnamed: LVLF5.W, R113.1
unnamed: C95.P$1, C98.+
unnamed: C98.-, LVLC5.B
unnamed: IC22.6, R115.2, R116.1
unnamed: LVLC5.W, R115.1
unnamed: C99.+, D15.P$1
unnamed: C99.-, LVLD5.B
unnamed: IC22.2, R117.2, R118.1
unnamed: LVLD5.W, R117.1
unnamed: A5.P$1, C100.+
unnamed: C100.-, LVLA5.B
unnamed: IC21.6, R119.2, R120.1
unnamed: LVLA5.W, R119.1
unnamed: B5.P$1, C101.+
unnamed: C101.-, LVLB5.B
unnamed: IC21.2, R121.2, R122.1
unnamed: LVLB5.W, R121.1
unnamed: LVLE5.W, R111.1
unnamed: C96.+, E5.P$1
unnamed: R123.2, R124.2, R125.2, R126.2, R127.2, R128.2, VOL5.B
unnamed: R129.1, VOL5.W
unnamed: IC24.6, R129.2, R130.1
unnamed: C102.+, IC24.7, R130.2, R132.1
unnamed: C102.-, EURO5.P$1
unnamed: C103.-, LINE5.P$1
unnamed: C103.+, IC24.1, IC24.2
unnamed: IC24.3, R131.2, R132.2
unnamed: D16.C, FB11.2
unnamed: +5.1, D16.A
unnamed: D17.A, FB12.2
unnamed: -5.1, D17.C
