hotchk155/six4mix/(commit log)

2022-05-24 front panel
    [1u-mixer.kicad_pcb, 1u-mixer.kicad_sch]
2022-08-08 id inputs A-F
    [1u_mixer_panel.brd, six4mix.brd, six4mix.sch]
2022-08-08 socket labels to docu layer
    [six4mix_panel.brd]
2022-11-22 power board
    [six4mix_power.brd, six4mix_power.sch]
2023-12-18 6.5mm holes
    [1u-mixer.kicad_pcb]
2023-12-18 updates v3 larger holes
    [1u-mixer.kicad_pcb]
